alexviznytsya/smart-home/screenshots/smart_home_preview.jpg

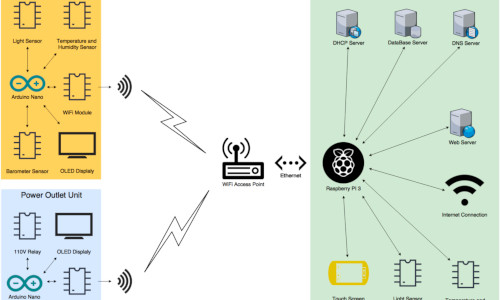
screenshots/smart_home_preview.jpg
